beunnn/aquadrone-control-station/(commit log)

2026-10-01 Initial commit: AquaDrone GCS hardware controller
    ESP32-P4 control box firmware (ESP-IDF v5.5) that reads a Thrustmaster
    Solaris Base joystick over USB HID host and drives an ArduPilot Rover
    through a mavlink-router hub:
    - Ethernet bring-up (IP101GRI RMII) and MAVLink 2 over UDP
    - RC_CHANNELS_OVERRIDE at 20 Hz: steering ch1, throttle ch3, motor ch6,
    trim ch7, speed scale ch10 (inverted slider), all clamped to 1000-2000
    - Joystick buttons for mode, arm (0.8 s hold), disarm, motor on/off,
    trim and a 3 s emergency-stop pulse; commands retried until COMMAND_ACK
    - Single physical button on GPIO3 enables/disables the RC override
    - Boot hold-off and held-at-boot protection against false button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
    [buttons.c, buttons.h, joystick.c, joystick.h, main.c]
2026-10-04 Added Tab5 project and MQTT
    [AquaDrone bt5.param, partitions.csv]
